stavell/xctracer-display/case/preview_section_cradle_x.png

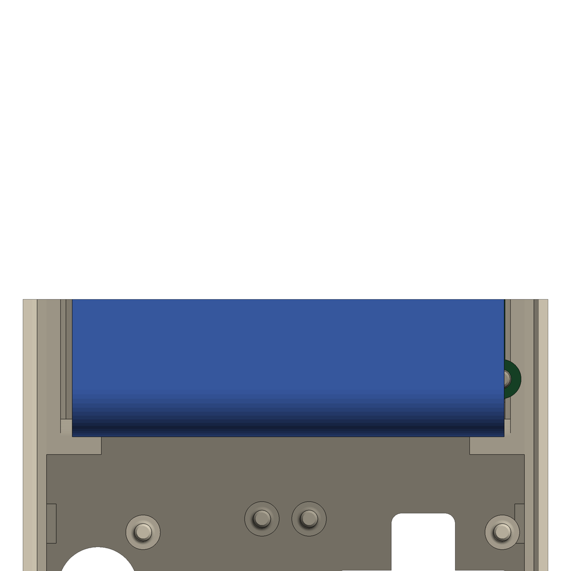
case/preview_section_cradle_x.png
