stavell/xctracer-display/case/preview_strap_outside.png

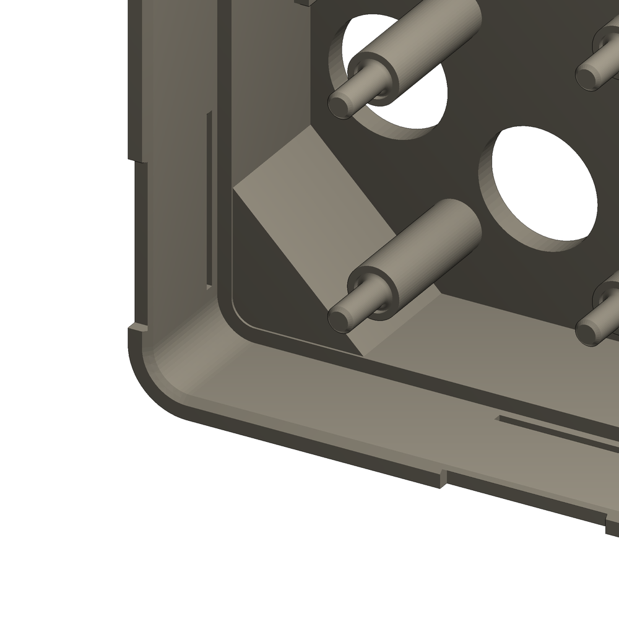
case/preview_strap_outside.png
