stavell/xctracer-display/host/terrain/img/bulgaria_200m_1bit.png

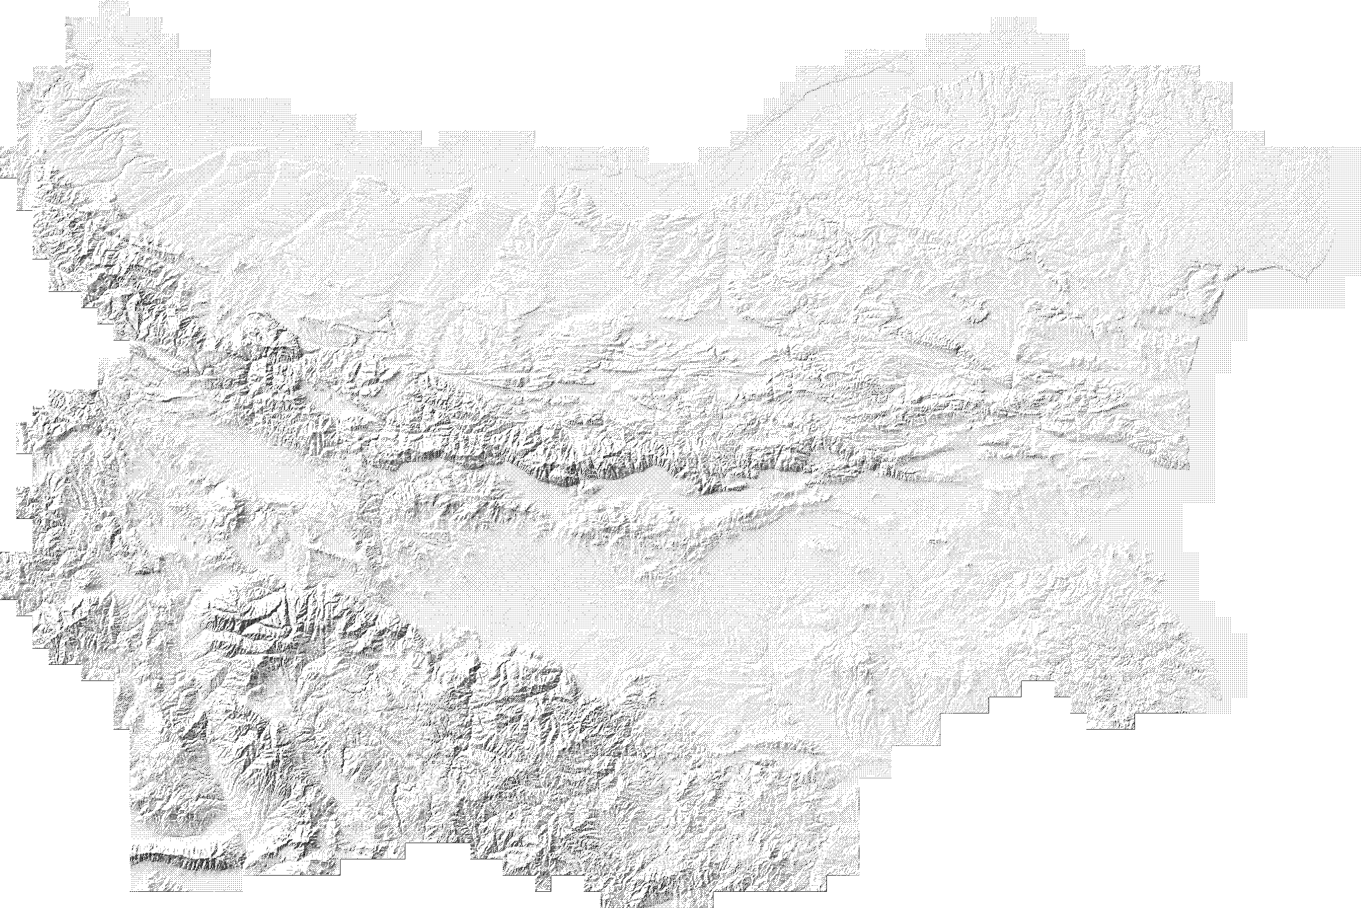
host/terrain/img/bulgaria_200m_1bit.png
