stavell/xctracer-display/host/terrain/img/map_pack_rila_100mpp.png

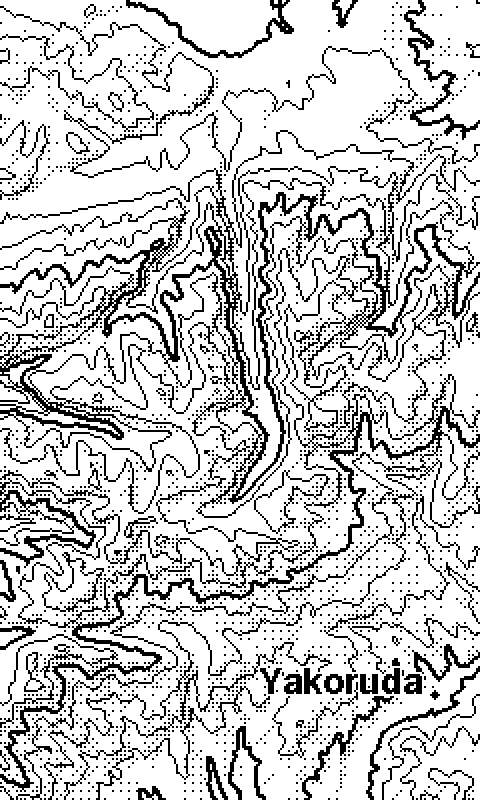
host/terrain/img/map_pack_rila_100mpp.png
