stavell/xctracer-display/host/terrain/img/map_pack_sopot_100mpp.png

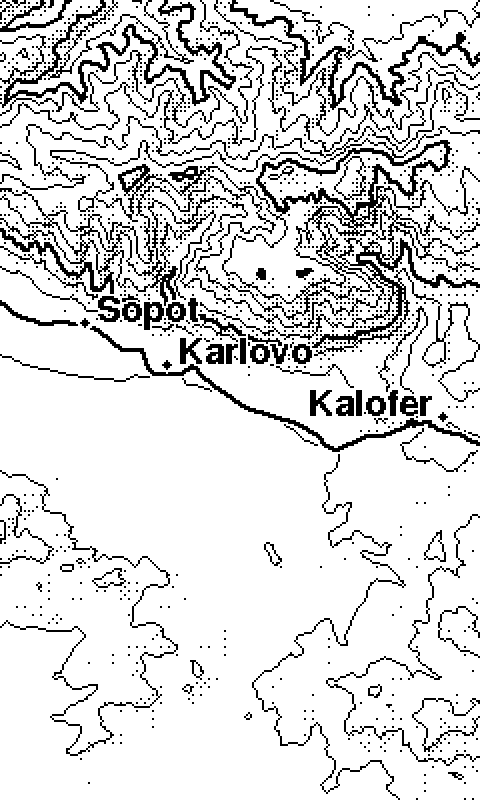
host/terrain/img/map_pack_sopot_100mpp.png
