stavell/xctracer-display/host/terrain/img/map_plovdiv_300mpp.png

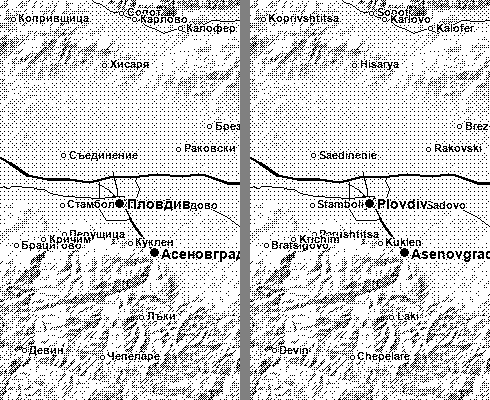
host/terrain/img/map_plovdiv_300mpp.png
