stavell/xctracer-display/host/terrain/img/map_shumen_200mpp.png

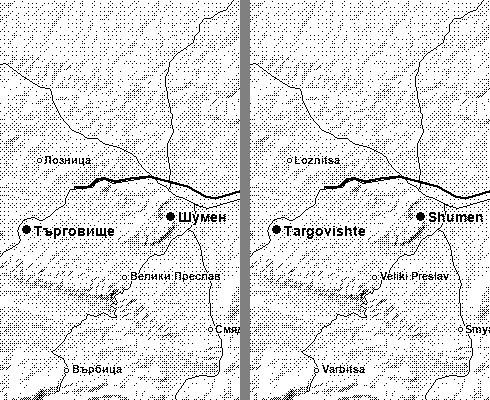
host/terrain/img/map_shumen_200mpp.png
