stavell/xctracer-display/host/terrain/img/map_sofia_100mpp.png

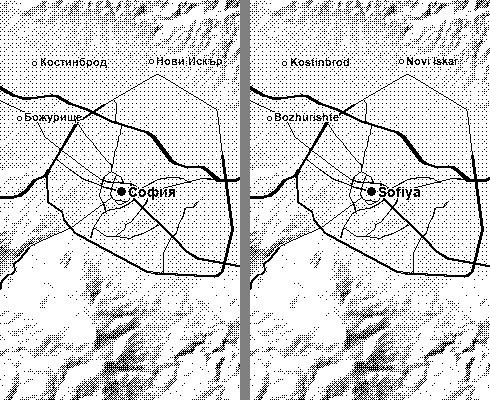
host/terrain/img/map_sofia_100mpp.png
