stavell/xctracer-display/host/terrain/img/map_sofia_200mpp.png

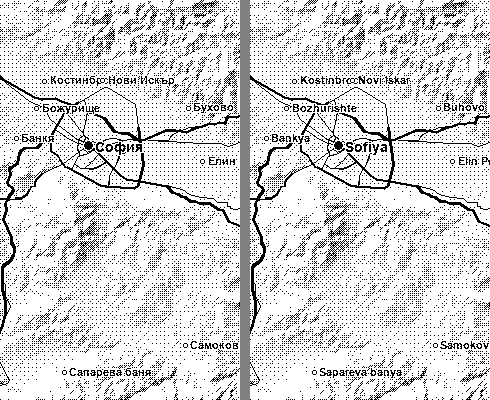
host/terrain/img/map_sofia_200mpp.png
