stavell/xctracer-display/host/terrain/img/zoom_flight_100mpp.png

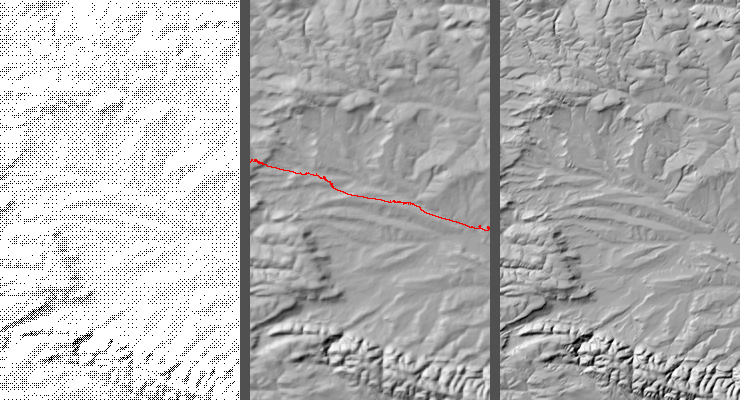
host/terrain/img/zoom_flight_100mpp.png
