stavell/xctracer-display/host/terrain/img/zoom_flight_100mpp_1bit_x3.png

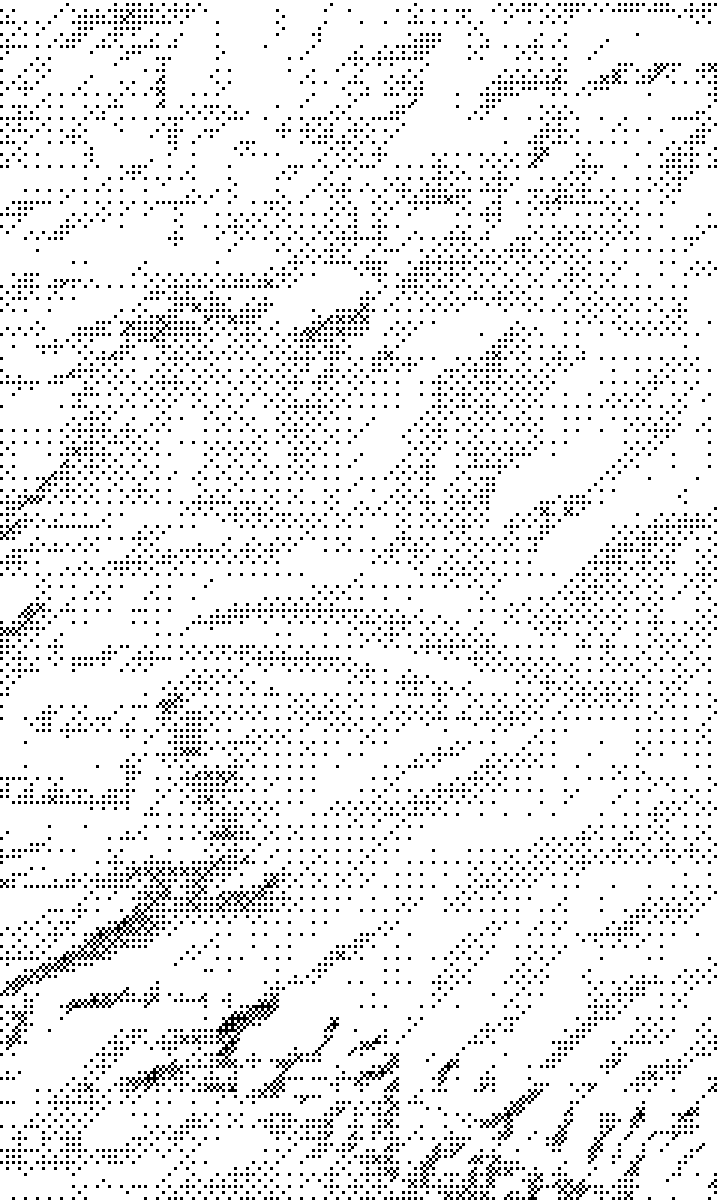
host/terrain/img/zoom_flight_100mpp_1bit_x3.png
