stavell/xctracer-display/host/terrain/img/zoom_rila_100mpp.png

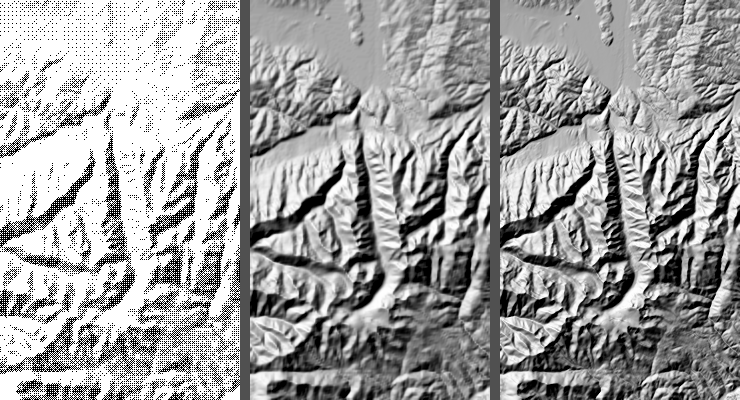
host/terrain/img/zoom_rila_100mpp.png
