stavell/xctracer-display/case/case_assembly.stl

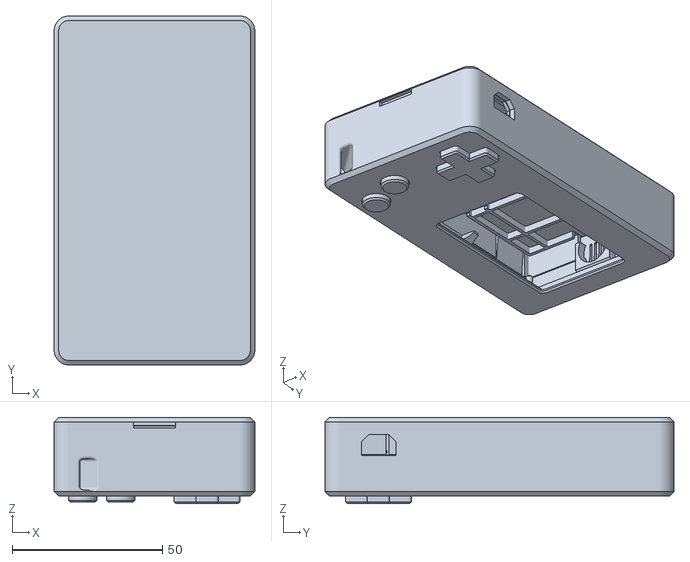
[picture p34: CAD file, 2026-10-22]
case/case_assembly.stl
66.9 x 116.2 x 28.7
