stavell/xctracer-display/case/case_back.3mf

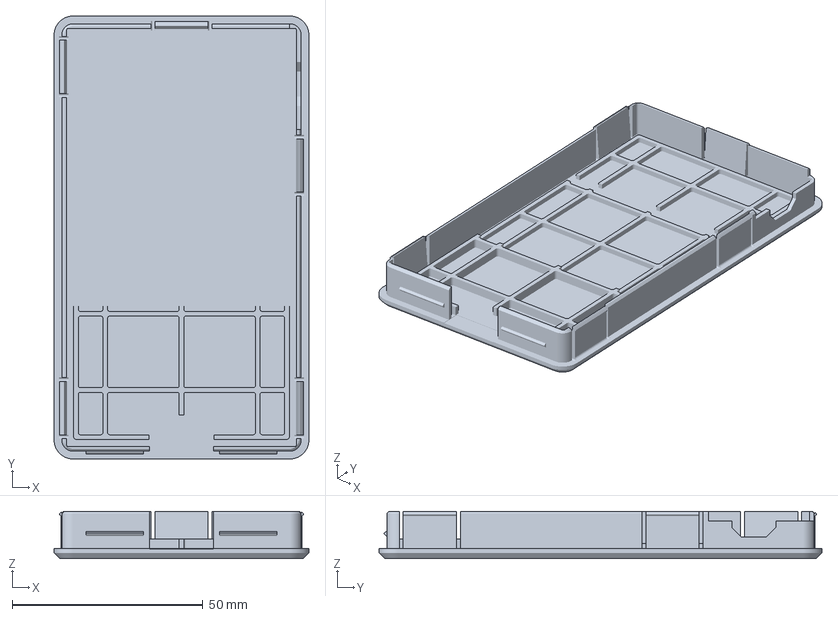
[picture p35: CAD file, 2026-10-22]
case/case_back.3mf
66.9 x 116.2 x 12.4 mm
