stavell/xctracer-display/case/case_buttons.step

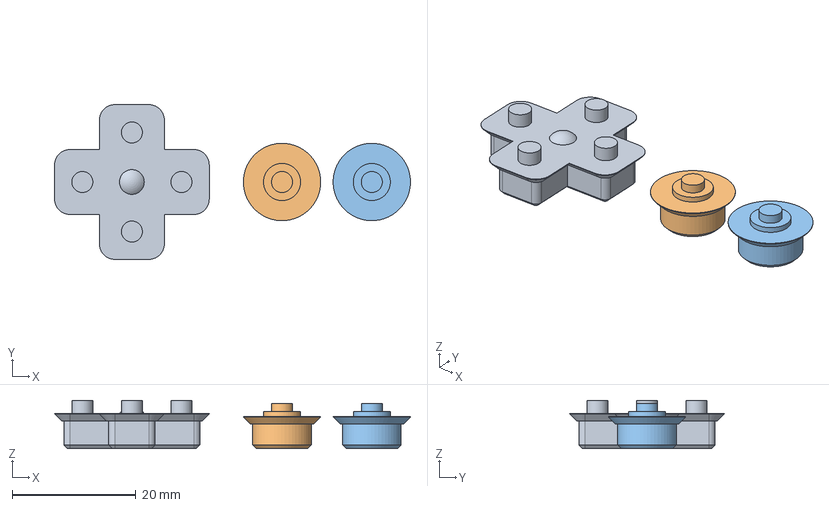
[picture p36: CAD file, 2026-10-22]
case/case_buttons.step
57.5 x 25.0 x 7.80 mm
