stavell/xctracer-display/case/case_seamtest_shell.stl

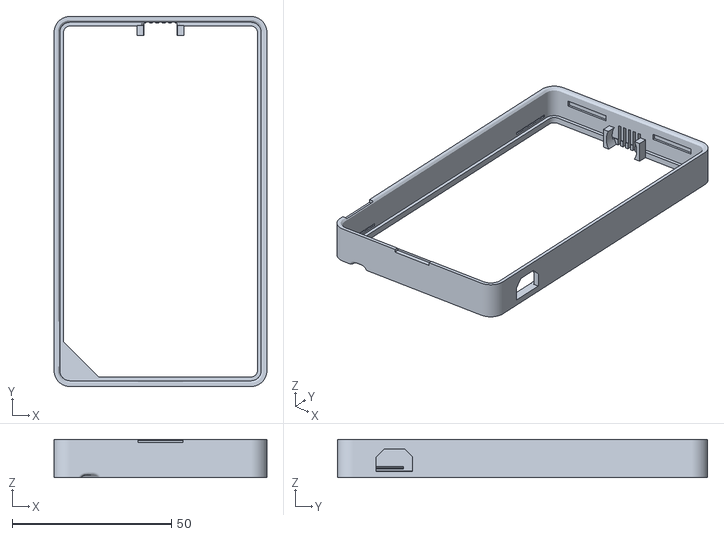
[picture p37: CAD file, 2026-10-22]
case/case_seamtest_shell.stl
66.9 x 116.2 x 12.0
