stavell/xctracer-display/case/case_shell.step

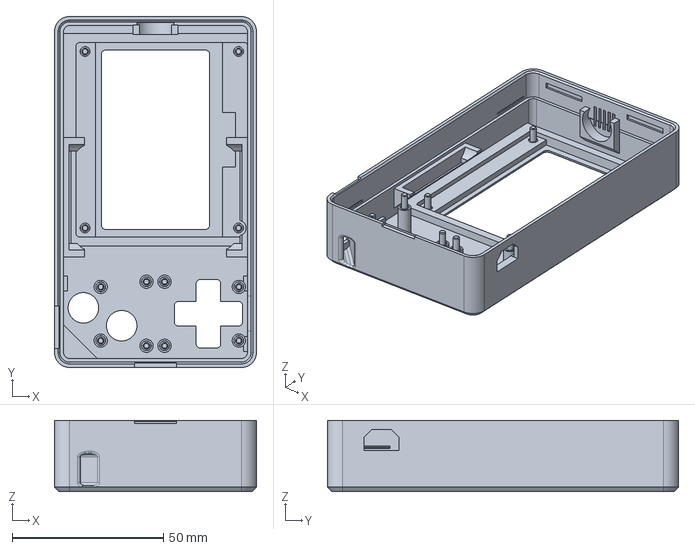
[picture p38: CAD file, 2026-10-22]
case/case_shell.step
66.9 x 116.2 x 23.6 mm
