stavell/xctracer-display/case/case_deck.step

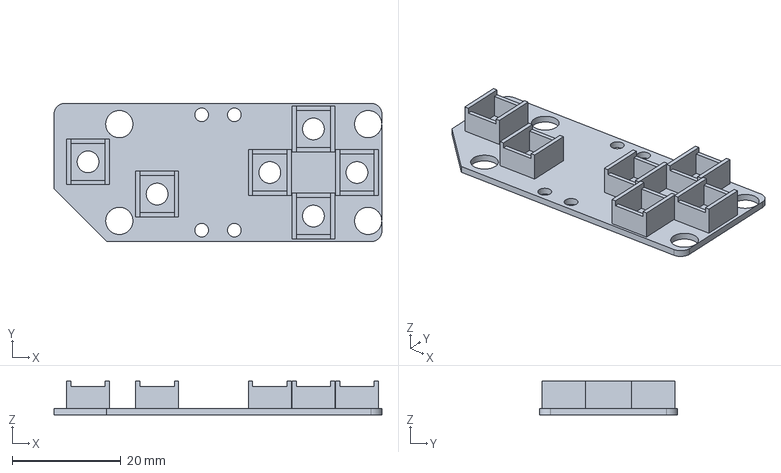
[picture p39: CAD file, 2026-10-22]
case/case_deck.step
60.3 x 25.4 x 6.20 mm
