stavell/xctracer-display/case/case_front.3mf

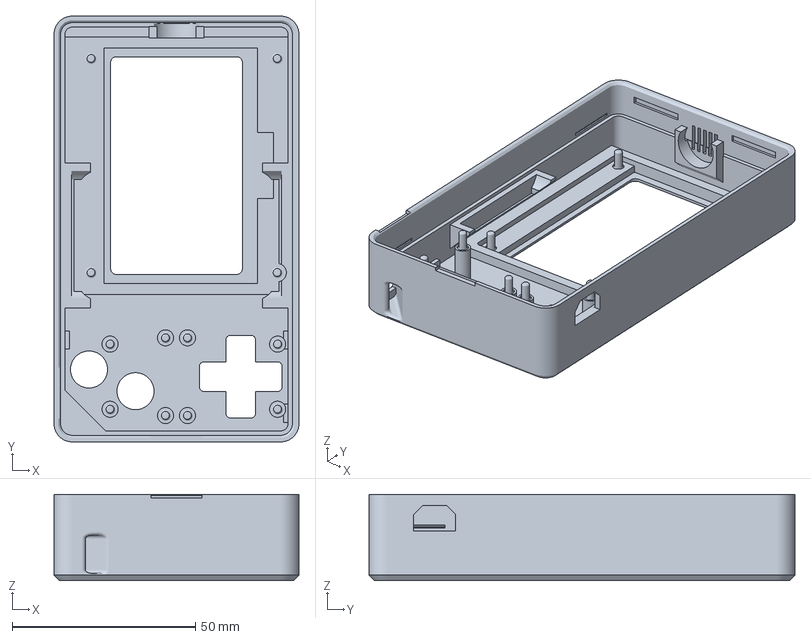
[picture p40: CAD file, 2026-10-22]
case/case_front.3mf
66.9 x 116.2 x 23.6 mm
