stavell/xctracer-display/case/case_testplate.stl

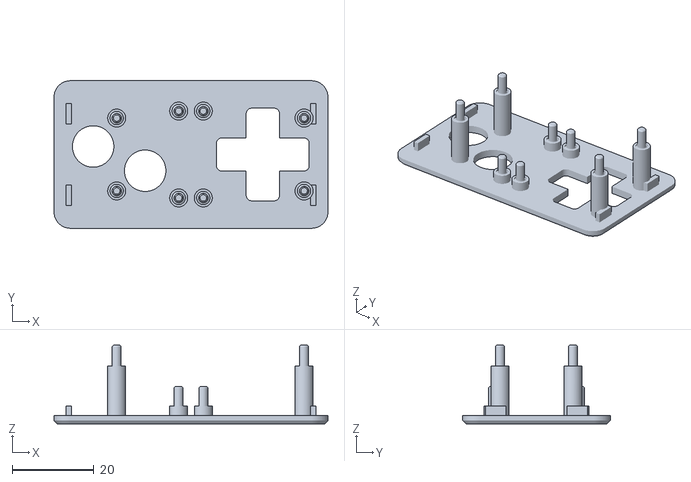
[picture p41: CAD file, 2026-10-22]
case/case_testplate.stl
66.9 x 36.0 x 19.2
