stavell/xctracer-display/case/case_shell_inlay.stl

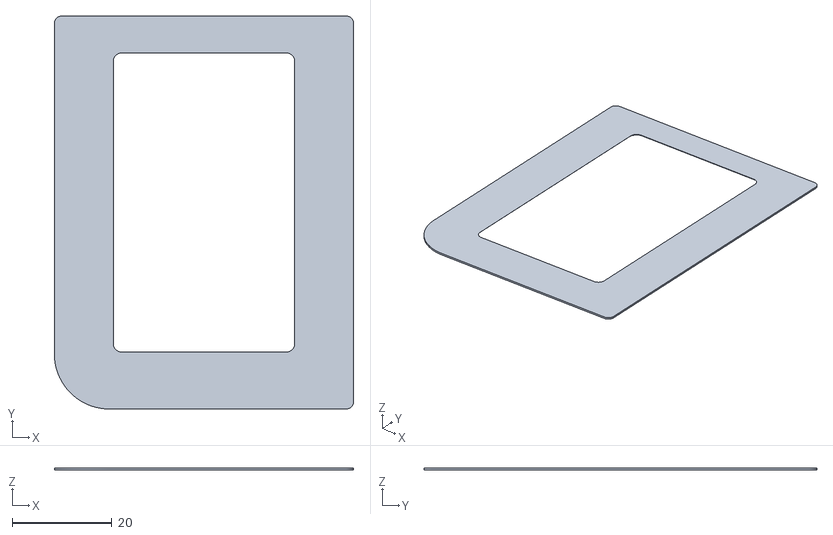
[picture p42: CAD file, 2026-10-22]
case/case_shell_inlay.stl
59.9 x 78.6 x 0.4
