stavell/xctracer-display/case/case_lid_inlay.stl

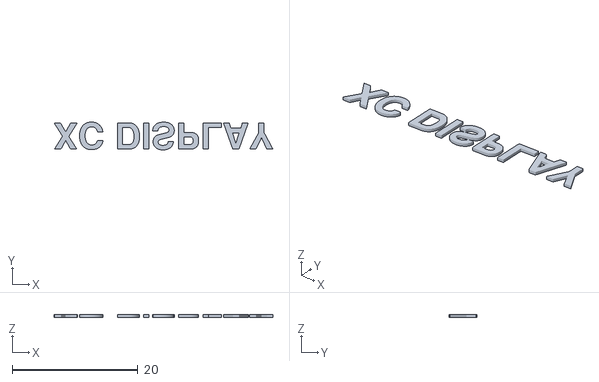
[picture p43: CAD file, 2026-10-22]
case/case_lid_inlay.stl
34.9 x 4.44 x 0.4
