stavell/xctracer-display/case/case_buttons_inlay.stl

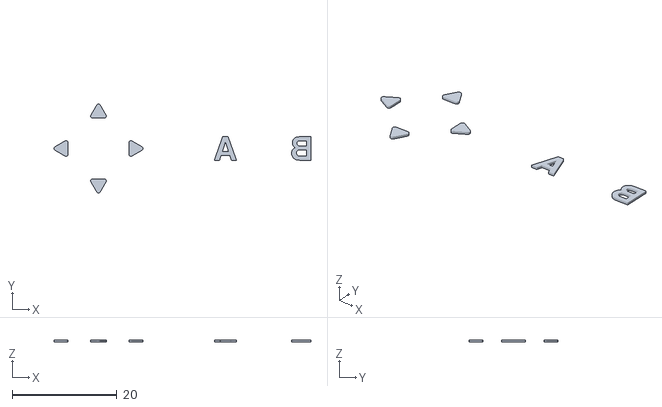
[picture p44: CAD file, 2026-10-22]
case/case_buttons_inlay.stl
49.1 x 17.0 x 0.4
