stavell/xctracer-display/(list of files, cad)

Other CAD files:
case/case_lid.step
case/case_buttons.3mf
case/case_buttons.stl
case/case_deck.stl
case/case_lid.stl
case/case_shell.stl
