stavell/xctracer-display/firmware/src/apps/vario/hw/diagnostics.cpp

#include "apps/vario/hw/diagnostics.h"
#include <Arduino.h>
#include <new>
#ifdef DIAGNOSTICS
#include "utility/debug.h"
#endif
#include "apps/vario/app/app.h"
#include "platform/hw/compass_lis.h"
#include "platform/hw/cyccnt.h"
#include "platform/hw/panel_sharp.h"
#include "platform/hw/pack_service.h"
#include "platform/sensors/ahrs.h"
#include "platform/sensors/compass.h"
#include "apps/vario/core/flight.h"
#include "apps/vario/core/wind.h"
#include "apps/vario/core/xctrc.h"
#include "apps/vario/view/prof.h"
#ifdef DIAGNOSTICS
#include <Fonts/FreeSansBold24pt7b.h>
#include "apps/vario/view/screens.h"
#endif

static App* gApp;
static SharpPanel* gPanel;
static CompassLis* gCompass;
static PackService* gPack;

void diagnosticsSetPack(PackService* pack) { gPack = pack; }

static char gScratch[560];
char* diagnosticsScratch(size_t* cap) {
  *cap = sizeof gScratch;
  return gScratch;
}

void diagnosticsSetApp(App* app) { gApp = app; }

void diagnosticsBegin(App* app, SharpPanel& panel, CompassLis& compass) {
  gApp = app;
  gPanel = &panel;
  gCompass = &compass;
}

#ifdef DIAGNOSTICS
// Timing of the numerically heavy pieces on this chip (diagnostics only). "windfit" is a one-off
// synthetic benchmark: one fitWind() over a canned 30 s circle, not the flight's real work. It used to
// be re-measured on every status line (and so looked like a cost paid on every tick, even with no data).
static uint32_t benchParseUs = 0, benchWindUs = 0, benchVmUs = 0;
static void runBench() {
  static bool done = false;
  if (done) return;
  done = true;
  static TrackPoint pts[30];
  static bool init = false;
  if (!init) {                                           // a 30 s circle in a 12 km/h wind
    for (int i = 0; i < 30; i++) {
      double hdg = (40 + 18 * i) * 0.017453292519943295;
      double gx = 10.0 * sin(hdg) - 3.33, gy = 10.0 * cos(hdg);
      pts[i] = {true, 43.0, 26.0, 1400, 1.5f, (float)(hypot(gx, gy) * 3.6), (float)fmod(atan2(gx, gy) * 57.29577951308232 + 360, 360)};
    }
    init = true;
  }
  uint32_t t0 = fastMicros();
  Sample s;
  bool ok = xctrcParse("$XCTRC,2026,8,16,10,38,24,0,43.252650,26.927967,1387.00,34.13,12.5,-1.30,,,,967.62,85*7c", s);
  uint32_t t1 = fastMicros();
  WindFit f = fitWind(pts, 30);
  uint32_t t2 = fastMicros();
  (void)ok; (void)f;
  benchParseUs = t1 - t0;
  benchWindUs = t2 - t1;
}

// One-off timing of the whole data path: 120 s of a circling flight (wind fit, circling detection, thermal
// finder and memory run every second) through a private FlightModel, plus a compass update. The model (36 kB) lives on the
// heap for the length of the run, not in .bss: it was 36 kB of static RAM that only this one-off needed (NOTES, "RAM budget").
static uint32_t benchFeedAvgUs = 0, benchFeedMaxUs = 0, benchCompassUs = 0, benchAhrsUs = 0;
static bool benchDone = false;
static void runFlightBench() {
  if (benchDone) return;
  benchDone = true;
  FlightModel* const benchFm = new (std::nothrow) FlightModel;
  if (!benchFm) return;                                // no room: no timing line, nothing else changes
  uint32_t sum = 0, mx = 0;
  const double D2R = 0.017453292519943295;
  double x = 0, y = 0, hdg = 40;
  for (int i = 0; i < 120; i++, hdg += 18) {
    double gx = 10.0 * sin(hdg * D2R) - 3.33, gy = 10.0 * cos(hdg * D2R);
    x += gx; y += gy;
    Sample s;
    s.fix = true; s.lat = 43 + y / 111320.0; s.lon = 26 + x / (111320.0 * cos(43 * D2R));
    s.speedKmh = (float)(hypot(gx, gy) * 3.6); s.course = (float)fmod(atan2(gx, gy) / D2R + 360, 360);
    s.vario = 2.5f; s.alt = 1400.0f + i; s.hh = 12; s.mm = i / 60; s.ss = i % 60;
    uint32_t t0 = fastMicros();
    benchFm->feed(s);
    uint32_t dt = fastMicros() - t0;
    sum += dt;
    if (dt > mx) mx = dt;
  }
  delete benchFm;
  benchFeedAvgUs = sum / 120;
  benchFeedMaxUs = mx;
  Compass c;
  Vec3 a, mg;
  a.x = 0.5f; a.y = 0.3f; a.z = 9.7f; mg.x = 20; mg.y = -10; mg.z = -35;
  uint32_t t0 = fastMicros();
  for (int i = 0; i < 10; i++) c.update(a, mg, (uint32_t)i * 12);
  benchCompassUs = (fastMicros() - t0) / 10;
  static Ahrs ahrs;                                    // a still unit with a little gyro noise
  Vec3 gy;
  t0 = fastMicros();
  for (int i = 0; i < 20; i++) { gy.x = 0.001f * (i & 3); gy.y = 0.001f * (i & 1); ahrs.update(gy, a, mg, (uint32_t)i * 12); }
  benchAhrsUs = (fastMicros() - t0) / 20;
}

// Cost of the primitives the views are built from, timed on the real canvas. Result line: bench ...
static char benchLine[200];
static char fontsLine[64];
static char packBenchLine[96];
static bool benchPending = false;

void diagnosticsBench() {
  profSetClock(fastMicros);                     // draw-time sections, printed by diagnosticsTick
  SharpPanel& p = *gPanel;
  p.setRotation(1);
  p.clear();
  Adafruit_GFX& g = p.gfx();
  uint32_t t0 = fastMicros();
  for (int i = 0; i < 10000; i++) g.drawPixel(i % 200 + 10, (i / 200) % 100 + 10, i & 1 ? 0 : 1);
  uint32_t pixelUs = fastMicros() - t0;
  t0 = fastMicros();
  for (int i = 0; i < 100; i++) g.drawLine(10, 100 + (i & 3), 209, 100 + (i & 3), 0);      // horizontal
  uint32_t hUs = (fastMicros() - t0) / 100;
  t0 = fastMicros();
  for (int i = 0; i < 100; i++) g.drawLine(100 + (i & 3), 150, 100 + (i & 3), 349, 0);     // vertical
  uint32_t vUs = (fastMicros() - t0) / 100;
  t0 = fastMicros();
  for (int i = 0; i < 100; i++) g.drawLine(10, 100 + (i & 3), 209, 299 + (i & 3), 0);      // diagonal
  uint32_t dUs = (fastMicros() - t0) / 100;
  t0 = fastMicros();
  for (int i = 0; i < 50; i++) g.fillRect(0, 0, 100, 20, i & 1 ? 0 : 1);
  uint32_t fillUs = (fastMicros() - t0) / 50;
  g.setFont(&FreeSansBold24pt7b);
  g.setTextSize(1);
  g.setTextColor(0);
  t0 = fastMicros();
  for (int i = 0; i < 100; i++) { g.setCursor(10, 60); g.print("1234"); }
  uint32_t textUs = (fastMicros() - t0) / 100;
  g.setFont(nullptr);
  // The same string through the pre-rotated glyph sheets. The build is timed once, with the RAM it holds.
  t0 = fastMicros();
  const Font1* big = nullptr;
  for (int i = 0; i < 5; i++) {
    if (i == 1) continue;                                  // Sans Bold 9 is not drawn anywhere
    const Font1* f = viewFont(viewGfxFont(i), 1);
    if (i == 4) big = f;
  }
  uint32_t buildUs = fastMicros() - t0;
  snprintf(fontsLine, sizeof fontsLine, "fonts build_us=%lu ram_bytes=%lu\n", (unsigned long)buildUs, (unsigned long)viewFontRam());
  Serial.print(fontsLine);
  uint32_t ftextUs = 0;
  if (big) {
    Bitmap1 bm = p.bitmap();
    t0 = fastMicros();
    for (int i = 0; i < 100; i++) drawText(bm, 10, 60, "1234", *big, DRAW_CLEAR);
    ftextUs = (fastMicros() - t0) / 100;
  }
  p.clear();
  p.invalidate();
  snprintf(benchLine, sizeof benchLine, "bench pixel_ns=%lu hline_us=%lu vline_us=%lu dline_us=%lu fill_us=%lu text_us=%lu ftext_us=%lu\n",
           (unsigned long)(pixelUs / 10), (unsigned long)hUs, (unsigned long)vUs,
           (unsigned long)dUs, (unsigned long)fillUs, (unsigned long)textUs, (unsigned long)ftextUs);
  Serial.print(benchLine);
  packBenchLine[0] = 0;
  if (gPack && gPack->hasPack()) {         // the whole pack read once in 1 kB blocks, then its CRC (flash read + CRC-32) over 256 B reads
    PackService::Bench pb = gPack->benchWholePack();
    snprintf(packBenchLine, sizeof packBenchLine, "packbench read_kBps=%lu crc_ms=%lu crc_ok=%d\n", (unsigned long)pb.readKBps,
             (unsigned long)pb.crcMs, pb.crcOk ? 1 : 0);
    Serial.print(packBenchLine);
  }
  benchPending = true;                     // print again with the first status line: nobody listens at boot
}
#else
void diagnosticsBench() {}
static uint32_t benchParseUs = 0, benchWindUs = 0, benchVmUs = 0, benchFeedAvgUs = 0, benchFeedMaxUs = 0, benchCompassUs = 0, benchAhrsUs = 0;
static void runBench() {}
static void runFlightBench() {}
#endif

// No vario App (box image, another app runs): the status that exists without it. Its own frame, off the long path.
static void __attribute__((noinline)) printNoVario(SharpPanel& panel, uint32_t& worstTickUs) {
  Serial.printf("st vario=none tick=%luus refresh=%luus send=%luus wait=%luus spito=%lu lines=%d up=%lu loopstack=%lu\n",
                (unsigned long)worstTickUs, (unsigned long)panel.refreshUs(), (unsigned long)panel.sendUs(),
                (unsigned long)panel.waitUs(), (unsigned long)panel.timeouts(), panel.lastLines(),
                (unsigned long)(millis() / 1000), (unsigned long)uxTaskGetStackHighWaterMark(nullptr) * 4);
  if (gPack) {
    char* pk = gScratch;
    gPack->formatStatus(pk, 260);
    Serial.print(pk);
    Serial.print("\n");
    gPack->formatLogStatus(pk, 120);                // "lg state=... used=..." (the flight log, README "Flight log")
    Serial.print(pk);
    Serial.print("\n");
  }
  worstTickUs = 0;
}

void diagnosticsTick(uint32_t now, uint32_t& worstTickUs) {
  App* const ap = gApp;              // the box image has no vario App while another app runs
  SharpPanel& panel = *gPanel;
  CompassLis& compassHw = *gCompass;
  static uint32_t last = 0;
  if (now - last < 2000) return;
  last = now;
  // Nobody listening: stop the profiler too (it only feeds these lines). The release build has no clock.
  const bool listening = Serial && Serial.availableForWrite() >= 120;
#ifdef DIAGNOSTICS
  profSetClock(listening ? fastMicros : nullptr);
#endif
  if (!listening) return;
  runBench();
  runFlightBench();
  if (!ap) { printNoVario(panel, worstTickUs); return; }
  App& app = *ap;
  uint32_t v0 = fastMicros();
  const ViewModel& vm = app.buildViewModel(now);
#ifdef DIAGNOSTICS
  benchVmUs = fastMicros() - v0;
#else
  (void)v0;
#endif
  Serial.printf("st ok=%lu bad=%lu fresh=%d fix=%d alt=%.0f spd=%.0f vs=%+.1f wind=%d/%.0f sim=%d link=%d pg=%d marks=%d trail=%d tick=%luus refresh=%luus send=%luus wait=%luus spito=%lu parse=%luus windfit=%luus viewmodel=%luus feed_avg=%luus feed_max=%luus compass=%luus ahrs=%luus",
                (unsigned long)app.linesOk(), (unsigned long)app.linesBad(), vm.fresh, vm.s.fix,
                vm.s.alt, vm.s.speedKmh, vm.s.vario, vm.wind.valid, vm.wind.speedKmh, vm.sim, (int)vm.link,
                (int)vm.page, vm.markCount, vm.trailCount, (unsigned long)worstTickUs, (unsigned long)panel.refreshUs(),
                (unsigned long)panel.sendUs(), (unsigned long)panel.waitUs(), (unsigned long)panel.timeouts(),
                (unsigned long)benchParseUs, (unsigned long)benchWindUs, (unsigned long)benchVmUs,
                (unsigned long)benchFeedAvgUs, (unsigned long)benchFeedMaxUs, (unsigned long)benchCompassUs, (unsigned long)benchAhrsUs);
#ifdef DIAGNOSTICS
  Serial.printf(" up=%lu heap=%d", (unsigned long)(millis() / 1000), dbgHeapUsed());
#endif
  Serial.printf(" lines=%d", panel.lastLines());
  {
    uint32_t ms, mx;
    bool mb, msun;
    app.takeMapStats(&ms, &mx, &mb, &msun);
    Serial.printf(" mapjob=%lu/%luus b=%d sun=%d", (unsigned long)ms, (unsigned long)mx, mb, msun);
  }
  Serial.print("\n");
#ifdef DIAGNOSTICS
  if (benchPending) { Serial.print(fontsLine); Serial.print(benchLine); Serial.print(packBenchLine); benchPending = false; }
  char* pl = gScratch;   // static: the loop stack is small
  profFormat(pl, sizeof gScratch);
  Serial.print(pl);
  Serial.print("\n");
  profResetMax();
#endif
  char desc[120];
  app.describeTracer(desc, sizeof desc);
  // reset cause (POWER->RESETREAS at boot: 0x1 pin, 0x2 watchdog, 0x4 soft reset incl. hard fault,
  // 0x10000 wake from System OFF; 0 = power-on) and the loop task's smallest free stack so far, in bytes
  Serial.printf("dev %s rst=0x%lx loopstack=%lu\nraw %s\n", desc, (unsigned long)readResetReason(),
                (unsigned long)uxTaskGetStackHighWaterMark(nullptr) * 4, app.lastRaw());
  if (gPack) {
    char* pk = gScratch;
    gPack->formatStatus(pk, 260);
    Serial.print(pk);
    Serial.print("\n");
    gPack->formatLogStatus(pk, 120);                // "lg state=... used=..." (the flight log, README "Flight log")
    Serial.print(pk);
    Serial.print("\n");
  }
  const Vec3& ca = compassHw.lastAccel();
  const Vec3& cm = compassHw.lastMag();
  const Vec3& cg = compassHw.lastGyro();
  Serial.printf("cmp on=%d present=%d acc=%.2f,%.2f,%.2f mag=%.1f,%.1f,%.1f gyr=%.1f,%.1f,%.1f hdg=%.1f src=%d cal=%d orient=%d fused=%d bias=%.2f rec=%lu\n", app.compassOn(),
                compassHw.present(), ca.x, ca.y, ca.z, cm.x, cm.y, cm.z, cg.x * 57.2958f, cg.y * 57.2958f, cg.z * 57.2958f,
                vm.heading, (int)vm.headingSrc, vm.calValid, app.mountIndex(), app.fused(), app.ahrs().biasDps(), (unsigned long)compassHw.recoveries());
  Ahrs::Debug d = app.ahrs().debug();
  Serial.printf("ahrs trust=%.2f magOk=%d hxy=%.1f mref=%.1f dip=%.3f dipref=%.3f gstd=%.3f still=%d bwins=%d winbad=%d\n",
                d.trust, d.magOk, d.hxy, d.magRef, d.dip, d.dipRef, d.gstdDps, d.stillWin, d.biasWins, d.winBad);
  worstTickUs = 0;
}
