stavell/xctracer-display/firmware/src/apps/vario/core/thermal3d.cpp

#include "apps/vario/core/thermal3d.h"
#include <string.h>

static const float R2D = 57.29577951f;

float ThermalColumn::cueGain = 2.5f;
bool ThermalColumn::cueLean = false;
float ThermalColumn::cueW[3] = {1.0f, 0.0f, 0.0f};
int ThermalColumn::cueMinTurns = 2;
float ThermalColumn::cueMaxM = 60.0f;
float ThermalColumn::secMinDeg = 180.0f;
float ThermalColumn::secWinDeg = 360.0f;
float ThermalColumn::secMaxShiftM = 200.0f;
float ThermalColumn::secMinShiftM = 10.0f;
float ThermalColumn::secMaxSpreadM = 1e9f;
float ThermalColumn::secMaxAgreeDeg = 90.0f;

static float wrap180(float a) {
  a = fmodf(a, 360.0f);
  if (a > 180) a -= 360;
  if (a < -180) a += 360;
  return a;
}

void ThermalColumn::reset() {
  n_ = 0;
  haveOrigin_ = false;
  rev_ = 0;
  analyzedRev_ = 0xffffffffu;
  headSet_ = false;
  headOk_ = false;
  clearResults();
}

void ThermalColumn::clearResults() {
  valid = false;
  circling = false;
  ageS = 0;
  nCircles = 0;
  nBands = 0;
  bandM = 50;
  leanValid = false;
  leanDeg = leanPer100 = leanRms = 0;
  coreX0 = coreY0 = coreZ0 = coreSx = coreSy = 0;
  cue = CoreCue();
  sec = SectorCue();
  trend = TREND_NONE;
  trendRatio = 0;
  zMin = zMax = 0;
  p0_ = nP_ = endPt_ = 0;
}

// The column's origin is the first point; a flight that wanders more than 6 km from it moves the origin so the
// floats stay fine (1 mm at 6 km).
void ThermalColumn::rebase(double dx, double dy) {
  for (int i = 0; i < n_; i++) { pts_[i].gx -= (float)dx; pts_[i].gy -= (float)dy; }
  lon0_ += dx / kx_;
  lat0_ += dy / 111320.0;
}

void ThermalColumn::push(uint32_t clockMs, bool fix, double lat, double lon, float alt, float vario) {
  if (!fix || !isfinite(lat) || !isfinite(lon) || !isfinite(alt)) return;
  if (n_ > 0 && (int32_t)(clockMs - pts_[n_ - 1].tMs) <= 0) return;
  if (!haveOrigin_ || n_ == 0) {
    lat0_ = lat;
    lon0_ = lon;
    kx_ = 111320.0 * cos(lat * 0.017453292519943295);
    haveOrigin_ = true;
  }
  double gx = (lon - lon0_) * kx_, gy = (lat - lat0_) * 111320.0;
  if (fabs(gx) > 6000.0 || fabs(gy) > 6000.0) {
    rebase(gx, gy);
    gx = gy = 0;
  }
  if (n_ == MAXP) {
    memmove(pts_, pts_ + 1, sizeof(Pt) * (MAXP - 1));
    n_--;
  }
  Pt p;
  p.gx = (float)gx;
  p.gy = (float)gy;
  p.z = alt;
  p.v = isfinite(vario) ? vario : 0;
  p.hdg = NAN;
  p.rate = NAN;
  p.tMs = clockMs;
  if (n_ > 0) {
    const Pt& q = pts_[n_ - 1];
    const float dt = (clockMs - q.tMs) / 1000.0f;
    if (dt > 0 && dt <= 3.0f) {
      // The heading of the ground track, not of the air-frame velocity: the turn count must not depend on how
      // good the wind estimate is (a wind that is a few m/s off makes the air-frame heading spin wildly at a
      // glider speed of 8 m/s). A circle still turns the ground course by 360 degrees unless the wind beats the glider.
      const float vx = (p.gx - q.gx) / dt, vy = (p.gy - q.gy) / dt;
      if (hypotf(vx, vy) >= 1.5f) {
        p.hdg = atan2f(vx, vy) * R2D;
        if (isfinite(q.hdg)) p.rate = wrap180(p.hdg - q.hdg) / dt;
      }
    }
  }
  pts_[n_++] = p;
  rev_++;
}

void ThermalColumn::setHead(bool valid_, double lat, double lon, float alt, float vario) {
  headSet_ = valid_ && isfinite(lat) && isfinite(lon) && isfinite(alt) && haveOrigin_ && n_ > 0;
  headLat_ = lat;
  headLon_ = lon;
  headAlt_ = alt;
  headVario_ = isfinite(vario) ? vario : 0;
  placeHead();
}
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
