stavell/xctracer-display/(commit log)

2026-10-15 Dashboard at 2 Hz
2026-10-15 Dashboard back to 1 Hz
2026-10-15 Standalone sensor dashboard: 5 pages, compass with calibration, user switch nav, power-off
2026-10-15 Vario discovery: BLE central, name-filter scan list, saved device, filter command
2026-10-15 Vario: subscribe to XC Tracer stream, parse XCTRC, Standard/Simple/Thermal screens, simulator, control script
2026-10-15 Vario: reconnect to the saved device by address or name
2026-10-15 Vario-only firmware: drop sensor pages (kept at tag sensor-dashboard), robust number formatting, host-draw gate
2026-10-15 Vario screen: strip on the left, inverted cell titles, one-line wind, Garmin-style compass, wind arrow in the compass corner
    [ui.cpp]
2026-10-15 Vario: injected/simulated data takes precedence over the live tracer stream
2026-10-15 No GPS fix: speed, track and wind read 0, speed cell titled NO FIX
    [ui.cpp]
2026-10-15 Layered architecture: core / view / app / hw with ports, PC emulator with mocks and tests
    Pure logic (parser, flight model, wind, sim) and drawing no longer know about Arduino or BLE.
    The app talks to hardware only through ports.h; Bluetooth callbacks only copy bytes into queues.
    firmware/emu runs the same code on the PC with sanitizers, 72 checks and a full-flight replay.
    [battery_adc.cpp, battery_adc.h, config_store.cpp]
2026-10-15 Serial status line every 2 s when a terminal is attached
2026-10-15 Thermal assistant page: wind-compensated map of the last 60 s, line thickness by climb rate; short press toggles pages
    [emu_main.cpp, flight.cpp, flight.h, screens.cpp, types.h, viewmodel.h]
2026-10-15 Thermal map memory: remembered thermal markers with strength, 3 min dashed track, edge arrow to the newest thermal; wind fit needs turning at both ends of the window
2026-10-15 Fix device build after the view-model change; laptop command to switch pages; page and memory in the serial status; replay --page
    (The previous commit did not build for the device because the serial status line still used the old accessor.)
    [ctl.py, igc_replay.py, laptop_ble.cpp, ports.h, protocol.h]
2026-10-15 Redraw at 3 Hz; serial status shows the slowest tick
2026-10-15 On-device timing of parse, wind fit and view-model build in the serial status; maths-load notes
2026-10-15 Match the saved tracer by address (name only for private addresses); address ids in the device list; device and raw-line diagnostics
2026-10-15 Magnetic compass fallback: HeadingSelector (GPS track or magnetometer), tilt-compensated heading, sphere-fit calibration, calibration screen and list row, sensor driver
    Fixes the earlier compass maths (gravity was not normalised, so headings were distorted).
    Tests: heading accuracy under tilt, calibration with hard iron, selector hysteresis, app flows.
    [compass.cpp, compass.h, compass_lis.cpp, compass_lis.h, config_store.cpp, config_store.h, ctl.py, emu_main.cpp]
2026-10-15 Orientation tools: serial logger and analyser that solve the sensor axis mappings (self-tested); notes
2026-10-15 Watchdog module (not wired in yet)
2026-10-15 Move diagnostics out of main.cpp, atomic config writes
    Status line and benchmarks live in hw/diagnostics; benchmarks (and the
    second FlightModel) compile only with -DDIAGNOSTICS (env feather_sense_diag).
    Config and magnetometer calibration are written to .tmp then renamed.
2026-10-15 BLE adapters: SPSC queues, private laptop frame buffer, loop-side scan/connect, fast reconnect
2026-10-15 Wire in the 8 s watchdog; report reset cause and loop stack margin (device verification pending)
    [diagnostics.cpp, power_nrf.cpp]
2026-10-15 Tracer: a new link cancels a pending rescan; ignore disconnects of other links. Plan status
    Found in review of the BLE hardening branch: after picking a new tracer while connected, the old
    link's disconnect could be processed by the loop after the new link was up and demote it.
2026-10-15 Sample the button every 10 ms from a software timer (D4)
2026-10-15 emu: fuzz tests (parser, App), soak command, millis() wrap tests
2026-10-15 Fix five bugs found by fuzzing: impossible positions accepted as a fix (NaN reached drawArrow), unchecked battery/time integers, unnormalised course, zero used as 'never' for time stamps
    All former known-bug checks are now hard checks; the fuzz delivers hostile lines unfiltered.
    Soak on the real 3 h flight x3: no allocations in tick, bounded buffers, 0 bad lines.
    [heading.cpp, laptop_ble.cpp, laptop_ble.h, screens.cpp, xctrc.cpp]
2026-10-15 Diagnostics hooks for device verification
2026-10-15 Wind profile page: temperature by altitude trace with lapse rate and inversions
    SHT30 port (IThermo) and hw driver read every 2 s; WindProfile bands carry a
    smoothed temperature; lapseRate/inversionAt helpers; profile page draws the
    temperature column. Tests and three new scenarios.
2026-10-15 Add scripts/flash.sh: refuse while the serial port is held, verify "Device programmed."
    The upload failures were caused by a forgotten serial logger holding the port and
    reading the bootloader's DFU replies. Record the cause, the rule, and the partial
    refresh measurement.
2026-10-15 Panel SPI at 4 MHz: full refresh 53 -> 27 ms, compass tick 108 -> 85 ms, no artefacts seen
2026-10-15 Fix NaN checks compiled away by -Ofast; magnetometer always on; panel SPI 8 MHz
    The core's -Ofast implies finite-math-only, so every isfinite() was folded to true on the device
    (the heading smoother stuck at NaN). Build with -O2 and refuse finite-math builds in core/types.h.
    [panel_sharp.cpp, types.h]
2026-10-15 Add on-device draw-time profiler and boot drawing micro-benchmark (diagnostics build)
2026-10-15 Draw straight into the Sharp frame buffer: Bitmap1 raster module and FastSharp canvas
    gfx/bitmap1: pure 1-bit bitmap ops (pixel, spans, fillRect, blit with key/mask,
    SET/CLEAR/INVERT/COPY), any size and stride, 4 rotations, whole-byte writes.
    hw/fast_sharp.h overrides the Adafruit_GFX primitives with bit-identical output.
    Equivalence tests against per-pixel references under the sanitizers.
    [fast_sharp.h, panel_sharp.h]
2026-10-15 Inline single-pixel path (thermal frame 103 -> 22 ms); animate at 20 fps
2026-10-15 Standalone compass screen with temperature and humidity when no vario data
    IThermo::read now returns humidity too (SHT31 readBoth); the app keeps the latest
    reading (10 s validity) and exposes ambientC/humidityPct. IPanel::bitmap() gives the
    view the native buffer for dithered grey (compass bezel ring). Without data the app
    redraws at the animation cadence while the heading glides, on every page.
2026-10-16 NOTES: fast text measured on the device (text 8.4x faster, 22 KB fonts)
2026-10-16 Panel: background EasyDMA send on SPIM2, DWT-based profiler clock
    Pack changed lines into a static buffer (core/sharp_frame), send with nrfx SPIM2
    non-blocking (CS driven by the driver), diagnostics send/wait/spito, fastMicros clock.
2026-10-16 Panel: send DMA-completed duration from the IRQ; notes on background send
2026-10-16 Add the enclosure (case/) with a README; README: flash script and case link
    [case_assembly.stl, case_lid.step, case_lid.stl, case_shell.step, case_shell.stl, viz_full.stl, viz_open.stl, viz_sectionY.stl]
2026-10-16 Live page: fast grey ring, circles and lines; work counters; profiler sections
    The compass ring cost one native row and 8 dither evaluations per pixel in portrait (48 ms on device).
    Pattern cache + Bayer table, gfx/shapes (fillRing, circle, line) with tests against references, emu
    count mode (build.sh count) and finer profiler sections.
2026-10-16 NOTES: compass page 48 -> 7.6 ms on the device
2026-10-16 Fast magnetic compass: 80 Hz sensors, time-based filter, 90 ms glide with deadband, 30 fps redraw
2026-10-16 Wind: skip trig for rejected windows, EKF wind age and seeding, home at speed crossing
    windfit= was a synthetic one-off benchmark re-run on every status line; run it once.
    fitWind rejects before trig, updateWind skips without a fix. EKF wind gets a real age
    (seconds since an update while turning), is seeded from the first circle fit when not
    confident, and home is the position where speed first crossed 10 km/h.
    [diagnostics.cpp, flight.cpp, flight.h, wind.cpp, windekf.cpp, windekf.h]
2026-10-16 Gyro fusion (Mahony AHRS) for the compass heading, configurable board mounting
    LSM6DS33 gyro at 104 Hz read in the accelerometer burst; core/ahrs fuses gyro, gravity and the
    horizontal magnetic field (heading-only correction, still-box bias learning, fast seed). Fused heading
    is the MAG source with a 30 ms glide; no or frozen gyro falls back to mag+accel. Board->case mounting is
    an index 0..23 (core/mount, flash file, ctl.py orient, CMD 0x16); per-chip mapping stays in hw.
    Emulator tests for the fusion, the 24 mountings, fallback and the app wiring.
    [ahrs.cpp, ahrs.h, compass.cpp, compass.h, compass_lis.cpp, compass_lis.h, config_store.cpp, config_store.h]
2026-10-16 I2C at 400 kHz for the 80 Hz sensor reads; notes on gyro fusion on the device
2026-10-16 Fused heading: no deadband, redraw on change, slower field correction with graceful trust
    [ahrs.cpp, ahrs.h, heading_smoother.cpp, heading_smoother.h]
2026-10-16 AHRS: a rejected field no longer blocks gyro bias learning; ahrs debug line in diagnostics
    [ahrs.cpp, ahrs.h, diagnostics.cpp]
2026-10-16 Thermal map moves continuously between samples: interpolated centre, heading and zoom glide, 33 ms redraw while it moves
2026-10-16 PLAN: multi-use box (platform + apps, vario/console images, UF2 switching)
2026-10-16 case: portrait layout, D-pad + A/B caps, electronics in shell, plain lid, strap tunnel
    [case_assembly.stl, case_buttons.step, case_buttons.stl, case_lid.step, case_lid.stl, case_shell.step, case_shell.stl, viz_full.stl]
2026-10-16 README: new enclosure (D-pad + A/B, clips only, velcro back, strap tunnel) with previews
2026-10-16 README: six front buttons in the new case
2026-10-16 case: rocker D-pad, Game-Boy caps with switch deck, centred window, front inlay, test plate, PS1240 buzzer
    [case_assembly.stl, case_buttons.step, case_buttons.stl, case_deck.step, case_deck.stl, case_lid.step, case_lid.stl, case_shell.step]
2026-10-16 Box: platform frame loop in AppHost, launcher, feather_sense_box image, whole-box PC player, stack check
    AppHost now polls input (key edges, short/long/hold, held time), ticks the app and runs clear/draw/present
    when the app wants a frame; the vario's redraw cadence is App::wantsFrame (replays, screens and test output
    byte-identical). LauncherApp + main_box.cpp (vario, Tetris, compass tool), A+B combo, key map for the six
    front buttons, tracer pause/resume on leaving the vario, build.sh play box / smoke, scripts/stack_check.py in
    check.sh (fitWind arrays made static: they were a 1.8 KB frame on the 4 KB loop stack).
    [app_host.h, box.h, box_shots.h, emu_main.cpp, input_button.h]
2026-10-16 Terrain on the vario: AGL, map page (cached north-up relief, roads, towns, track), TerrainKit, player --pack, tests, docs
2026-10-16 Launcher refactor: home screen, Settings app, box settings in the platform key store
    Home screen with icon tiles and status bar; vario menu only tracer choice + Home;
    compass calibration, mounting, start-up app, time zone, About moved to a Settings app
    on platform/settings (BoxSettings, CompassCal); one-time migration of the old files;
    Tetris pause screen Home; tests, smoke run, docs.
2026-10-16 PLAN: games at maximum frame rate; flight simulator idea
2026-10-16 WIP: thermal3d core (per-circle core points, lean, bands, trend), not yet wired
2026-10-16 WIP: thermal3d wired into FlightModel and App (pages not drawn yet), tests
2026-10-16 WIP: flight sim tests (polar, turns, stall, tilt map, air, ridge, landing, voxel, top-down, game mode), box and player hooks
    [box.h, glider.cpp, glider.h, main_box.cpp, play.cpp]
2026-10-16 Flight simulator step 1: game mode in the platform, sim core, top-down and 3D views, tilt steering, tests, docs
    AppHost game mode (fixed 20 ms frame clock with catch-up, stats), apps/games/sim (glider polar and turns, seeded air with thermals, ridge lift
    and lee sink from the DEM, height cache, top-down and voxel views, HUD, tilt mapping), box and PC player integration, 570 checks, timing
    bench with PC and M4 estimates, README, NOTES and PLAN.
    [emu_main.cpp, sim_bench.cpp, sim_shots.h, voxel.cpp, voxel.h, world.cpp]
2026-10-16 Centring page docs, ctl.py page, NOTES measurements, smoke script, scenario fix
    [ctl.py, emu_main.cpp]
2026-10-17 Wind EKF: learn only while turning, reopen covariance after an outlier run, restart from persistent circle-fit disagreement; regression tests with real-flight fixtures
    [flight.cpp, flight.h, make_wind_fixture.py, windekf.cpp, windekf.h]
2026-10-17 Sim: chase camera, Day settings (thermals, wind), three NE plateau takeoffs, tests
2026-10-17 Sim: playable air, chase camera, Day settings, NE takeoffs; scripts/check.sh passes
2026-10-18 Box image RAM: shared lazy app arena, compass tool as one object, sim optional (-DBOX_WITH_SIM), heap guard in check.sh
    feather_sense_box had 2376 bytes of heap and did not boot. Tetris and the compass tool now share one AppArena via LazyApp (built in begin, destroyed in end); heap 97316. scripts/ram_check.py fails below 48 KB.
    [box.h, lazy_app.h, main_box.cpp]
2026-10-18 Map loader, pure part: flash header, serial frames, loader state machine, flash block reader, tests
2026-10-18 Map pack on the device: QSPI flash driver (nrfx), PackService with USB serial loader, wired into vario and box images
2026-10-18 NOTES: map pack in QSPI measured on the device (load 5 kB/s, read 6.9 MB/s quad)
2026-10-19 Parallel build and test: make with per-flag-set objects, one test process per function, check.sh stages side by side (clean 10:49 -> 2:26)
2026-10-19 Heading shown with one decimal, wrapped to 0.0..359.9 (never 360); shared bearingText helper + test
2026-10-19 Flight sim on one button: short/long menus, tilt from the board accelerometer, zero page before the first flight
    [accel_tilt.h, box.h, main_box.cpp, sim_app.cpp, sim_app.h, sim_box.h, tilt.h]
2026-10-19 Clock sleep: power off keeps the time (System ON low-power sleep with a clock screen), Settings > Power off Clock/Off
    Box image: the 3 s hold sleeps with radios, compass and QSPI flash off and only the panel showing HH:MM (--:-- when unknown)
    and the battery, redrawn once a minute; a 1 s hold wakes into the start-up app without a reset. Low battery falls into
    System OFF. Pure state machine and view in platform/power, hardware in power_nrf.cpp. Vario-only image unchanged.
    Tests, renders, NOTES (sleep current estimated, not measured), README.
    [box.h, box_shots.h, clock.h, clock_sleep.h, clock_view.h, main_box.cpp, mocks.h]
2026-10-19 Game status line: once-a-second gm line (fps, catch-up, dropped, busy, step/draw/present, sim parts), simbench device model; fix garbage worst tick
    [app_host.h, diagnostics.cpp, diagnostics.h, game_log.cpp, game_log.h, game_probe.h, height_cache.cpp, height_cache.h]
2026-10-19 gm line: LazyApp forwards gameInfo (the sim's part was missing); SIM_BENCH build: the sim flies itself (map/3D alternating) for unattended device timing
    [game_log.cpp, lazy_app.h, main_box.cpp]
2026-10-19 Box image: the vario is a LazyApp (VarioBox = App + adapter + terrain kit) in the shared arena
    Heap of feather_sense_box 49216 -> 87936. Leaving the vario destroys it (flight state lost, tracer resumes on return);
    diagnostics cope with a missing App; test box_vario_lazy.
    [box.h, diagnostics.cpp, diagnostics.h, main_box.cpp, main_vario.cpp]
2026-10-19 WIP sim speed: fast exp/log/pow, word-wise memory helpers, blit by words, game catch-up cap 2, draw overlaps panel DMA, finer profile parts, device micro-benchmark
2026-10-19 Air: tile caches its timing, skips dead thermals before hashing
    [air.cpp, air.h]
2026-10-19 Notes: sim speed pass device numbers (WIP, check.sh not run)
2026-10-19 Build: -fno-math-errno (47 -> 1 libm sqrtf calls, -1.9 kB); notes on CPU options pass (no board attached)
2026-10-19 Per-file -O3 for the sim / gfx hot files (3D 37 -> 41 fps on the device); notes: RAM code and LTO measured and dropped
2026-10-19 Map page and number text without soft double: float track/xform/box maths relative to the double origin, integer fnum; notes
2026-10-19 WIP sim leftovers (agent stopped): BLE off in games, restart stall, chase sprite, bench; checks not run
    [app_host.h, box.h, chase.cpp, height_cache.cpp, height_cache.h, laptop_ble.cpp, laptop_ble.h, main_box.cpp]
2026-10-19 Map page: incremental picture job (no 1.9 s stall), sun-lit hillshade, paper-plane pilot, no railway classes, credits off the map page
    [diagnostics.cpp, main_box.cpp, main_vario.cpp, map_page_shots.h, screens.cpp, sim.cpp, sun.cpp]
2026-10-19 Sim HUD: flight time and distance from takeoff; finish sim leftovers (BLE gate, restart stall, sprite, edge margin)
    [sim_app.cpp, sim_hud.cpp, sim_hud.h, world.cpp, world.h]
2026-10-19 Sim: HUD without snprintf, NOTES device numbers, PLAN status
2026-10-19 PLAN: intro device numbers, open items
2026-10-19 Intro end frame: just stavl.com; cheaper cloud front (6 larger puffs)
2026-10-19 Two-step hold power-off: 3 s = clock sleep, keep holding 3 s more = System OFF (countdown bar); remove Settings Power off row
2026-10-19 Clock sleep as a weather station: temperature, humidity, 24 h pressure chart, tendency arrow, forecast pictogram (BMP280 driver, WeatherLog, tests, renders)
2026-10-19 Thermal assistant review (theory, cue hit rate on whole flights, onboard sensors); PLAN backlog
2026-10-19 Flight log (tracer lines + gyro yaw rate in the QSPI tail), gyro dead reckoning core, logdl.py + logeval, QSPI release from deep power-down at boot
2026-10-19 Sleep screen redesign: stroke-numeral desk clock, dithered pictograms, area chart, thin countdown bar
    [box_shots.h, clock_view.h]
2026-10-19 Set the clock from the PC (TIME over USB, settime.py, 30-day validity, date on the sleep clock); intro no longer skipped by the wake hold's release; clock-sleep event ring
    [box.h, clock.h, input_button.h, load_pack.py, log_shell.cpp, log_shell.h, logdl.py, main_box.cpp]
2026-10-19 Longer intro (4.5 s, a full thermal turn), XC Display title, XC pod-harness pilot and slimmer wing in the sim sprite and the intro
2026-10-19 3D compass in the Compass & weather tool: perspective card in a glass dome, AHRS-driven, spring-damped, dither-shaded, 50 fps
    Card with graduated raised rim, projected numerals and letters, Lambert-shaded wall, soft shadow, glass reflections, exact heading
    number, bubble level, weather cells, calibration / disturbance / no-data states. Short press swaps to the flat dial page; menu and
    exits unchanged. PC player: arrows / mouse tilt the virtual box (mock gyro follows the motion). Tests, contact sheet, notes.
    [ahrs.h, box.h, compass3d.cpp, compass3d.h, compass3d_sheet.py, compass3d_shots.h, emu_main.cpp, mocks.h]
2026-10-20 3D compass: pressure with 3 h trend arrow in the strip (WeatherLog and clockview::trend reused), bubble level moved to the dome's corner
2026-10-20 Weather sleep screen: temperature with one decimal (stroke numerals with a decimal point), faint 6 h grid on the 24 h chart (wall-clock 00/06/12/18, else 6 h back from now) and a dotted mid line
2026-10-20 Compass tool: new flat page (big heading numerals + point, full-width heading tape with notch, level, field quality, calibration state, weather strip)
    Separate commit: drop it to get the old flat dial page back. Both pages run at 50 fps.
2026-10-20 Docs: showcase sheet (dome at tilt 0/30/60 clamped, flat page, weather screen) and weather grid render
2026-10-20 Revert "Compass tool: new flat page (big heading numerals + point, full-width heading tape with notch, level, field quality, calibration state, weather strip)"
    This reverts commit b4c196b1dedf5a2cc8d2dd4a2812b7c8fda66c25.
    [compass3d.cpp, compass3d.h, compass3d_sheet.py, compass3d_shots.h]
2026-10-20 Box: system sheet (hold 3 s / A+B), 6 s hold = power off, hold bar, Home rows removed, shared title bar and hint line, six-button vario input, battery % on the sleep screen
2026-10-20 System sheet: sheet object owned by the box image (diag heap unchanged), hold bar at the bottom edge, sheet shots in the smoke run, README and CLAUDE.md rules; sim: cloud pass in its own stack frame
2026-10-20 Shared 3D library: voxel renderer, height cache, sky, chase camera, Air, Glider, World, takeoffs move from apps/games/sim to platform/gfx3d (namespace gfx3d); intro no longer includes the sim. Render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
    [air.cpp, air.h, chase.cpp, chase.h, gfx3d_use.h, glider.cpp, glider.h, height_cache.cpp]
2026-10-20 Motion service in the platform, shared compass dial widget, compass as its own app
    platform/sensors/motion: sensor orchestration moved out of the vario App (mounting, calibration, compass, gyro fusion, fused
    decision); the App, the compass app and the Settings calibration use it. platform/gfx/widgets/compass_dial: the dial drawing
    shared by the vario's compass page (frames byte-identical) and apps/compass, which no longer wraps a vario App.
    [box.h, box_shots.h, compass3d_shots.h, compass_app.cpp, compass_app.h, main_box.cpp]
2026-10-20 Retained pressure history and clock, APP / APP? bench commands, wth status line, settime port detection, one launcher label size
2026-10-20 Retained RAM in the top page (the bootloader wiped .noinit on every reset), REBOOT bench command, pwr event ring, compass bus recovery, box_motion_live and box_pwr_log tests
    [app_host.h, compass_lis.cpp, compass_lis.h, diagnostics.cpp, log_shell.cpp, log_shell.h, main_box.cpp]
2026-10-20 v1.0 documentation sweep: README rewrite, CLAUDE/PLATFORM/NOTES fixes, short PLAN, regenerated docs/screens
    [main_box.cpp, retained.h]
2026-10-20 Claude Pet daemon (step 3): state machine, slots, encoder, fake-ble feed, HTTP hook receiver, status/install, fixtures and tests
2026-10-20 Claude Pet step 2: the Agents app (apps/pet), placeholder art, shots, demo feed, play pet --feed
    Change-driven (6 fps waiting incl. 1 Hz inversion, 2 fps working, 1 frame / 3 s otherwise, none when stale),
    40 px top bar, 2x3 cells, escalation by minutes, hatch / wave, registered in the box image (not the examples image).
2026-10-22 Case: measured display, battery and switches; tolerances and a wire channel
    Glass + display PCB 3.5 mm, battery 55x35x13, TS-061 switches 4.2 free / 4.0
    pressed. Depth now follows the battery stack (24.7 mm). Display pocket +0.8,
    battery 1.5 mm slack and 1.5 mm foam room, 6 mm wire channel between the
    button band and the battery. Cap stubs derived from the switch height and
    reach through the deck; D-pad pivot retuned for 0.2 mm travel, fitcheck
    guards the centre-press / arm-press order.
    [case_assembly.stl, case_buttons.step, case_buttons.stl, case_deck.step, case_deck.stl, case_lid.step, case_lid.stl, case_shell.step]
2026-10-22 Case: display glass height measured (PCB 1.6, with glass 3.6)
    [case_assembly.stl, case_buttons.step, case_deck.step, case_lid.step, case_lid.stl, case_shell.step, case_shell.stl]
2026-10-22 Case docs: depth 24.8
2026-10-22 Case: TS-061 body measured (4.0 + 0.2 actuator), stubs follow
    [case_assembly.stl, case_buttons.step, case_buttons.stl, case_deck.step, case_deck.stl, case_lid.step, case_lid.stl, case_shell.step]
2026-10-22 Case: switch leg room 4.5 mm and leg slots in the deck cups (generic 6x6 drawing)
    [case_assembly.stl, case_buttons.step, case_deck.step, case_deck.stl, case_lid.step, case_lid.stl, case_shell.step, case_shell.stl]
2026-10-22 Case: switch cups 6.8 mm on the legs side (legs make the switch 6.5 across)
    [case_assembly.stl, case_buttons.step, case_deck.step, case_deck.stl, case_lid.step, case_shell.step]
2026-10-22 Case rev 5: flat lid with wordmark inlay, dark screen panel front, flat caps with body-colour legends
    [case_assembly.stl, case_buttons.step, case_buttons.stl, case_buttons_inlay.stl, case_deck.step, case_deck.stl, case_lid.step, case_lid.stl]
2026-10-22 Case: centre legends and wordmark on their ink bounding box (B was off-centre)
    [case_buttons.step, case_buttons.stl, case_buttons_inlay.stl, case_deck.step, case_lid.step, case_lid.stl, case_lid_inlay.stl, case_shell.step]
2026-10-22 Case: lid wordmark cap height 4.2 mm so the stems are two 0.4 mm lines
    [case_buttons.step, case_deck.step, case_lid.step, case_lid.stl, case_lid_inlay.stl, case_shell.step]
2026-10-22 Case: framed panel with picture-mat margins (top 9, sides 11.4, bottom 12.5), 7 mm around the controls, case 123.7 mm long, alt preview
    [case_assembly.stl, case_buttons.step, case_deck.step, case_deck.stl, case_lid.step, case_lid.stl, case_lid_inlay.stl, case_shell.step]
2026-10-22 Case: tighter margins (top 7, bottom 11, ctrl gap 5), outer 116.2 mm
    [case_assembly.stl, case_buttons.step, case_deck.step, case_deck.stl, case_lid.step, case_lid.stl, case_lid_inlay.stl, case_shell.step]
2026-10-22 Case: drop-safe rev 5 (battery hooks, 2.6 mm ribbed lid, wide tabs + top tongues), seam test shell, window option, Forest colours, Bambu Studio 3mf projects
    [case_assembly.stl, case_back.3mf, case_buttons.3mf, case_buttons.step, case_deck.step, case_front.3mf, case_lid.step, case_lid.stl]
2026-10-22 Case rev 6: heat-staked boards, battery cradle with foam tape, tapered lid fingers (0.92 %), thick strap bar, printcheck.py (0.4 mm cantilever limit), new previews
    [case_assembly.stl, case_back.3mf, case_buttons.3mf, case_buttons.step, case_buttons.stl, case_deck.step, case_deck.stl, case_front.3mf]
2026-10-22 Clock sleep power: stop the 10 ms button timer, cancel a pending tracer connect, VCOM flip over SPI each second
    [input_button.h, main_box.cpp, panel_sharp.cpp, panel_sharp.h, power_nrf.cpp, power_nrf.h, tracer_ble.cpp, tracer_ble.h]
2026-10-22 Clock sleep: wake on the switch's SENSE (PORT event -> PPI -> EGU3) instead of a GPIOTE IN channel
2026-10-23 Awake power: blue LED off (Bluefruit autoConnLed), tracer connection interval 50-75 ms, QSPI deep power-down after 5 s idle
2026-10-23 Hold the unused NeoPixel's data pin low from boot (no back-powering once its 3.3 V is cut)
2026-10-23 VCOM over SPI: EXTCOMIN is not wired; drop its timer, flip VCOM after 1 s with no transfer (keepVcom)
    [main_box.cpp, main_vario.cpp, panel_sharp.cpp, panel_sharp.h, pins.h, power_nrf.cpp]
2026-10-23 README: display wiring as checked (SCLK, MOSI, CS on RX, power; no EXTCOMIN, DISP, EXTMODE)
2026-10-23 Sim 3D to 50 fps in steady flight (draw 20.2 -> 14.6 ms), smooth 2D map scrolling
    Voxel: word-wise column composer (4 rows per ray), split near/far step loops. Bitmap1::vline fast path for portrait,
    inline short runs in nativeRect, 64-bit glyph rows in Atlas::draw. All pixel-identical (new build.sh voxdigest oracle,
    131 emulator screens byte-identical). Map view: picture origin snapped to its pixel grid and dither fixed to the
    ground, so re-render swaps no longer jolt the map (test sim_topdown).
    [topdown.cpp, topdown.h, voxel.cpp, voxel.h, voxel_digest.cpp]
2026-10-23 Map app: topo relief + contours from a 64 px tile cache, roads and towns, pan/zoom, GPS from the tracer, North up / Compass
    Road, town and label drawing lifted to platform/map (the vario's map page draws byte-identical), IFixSource for apps that
    do not own the tracer.
